takuhoTech/CelestNavi/README.md

# 星導 CelestNavi-Fusion
Ready-to-use GNSS+CLAS receiver with integrated patch antenna
