takuhoTech/CelestNavi/Hardware/Antenna_Module/Resource/GNSS_Frequency-Bands.png

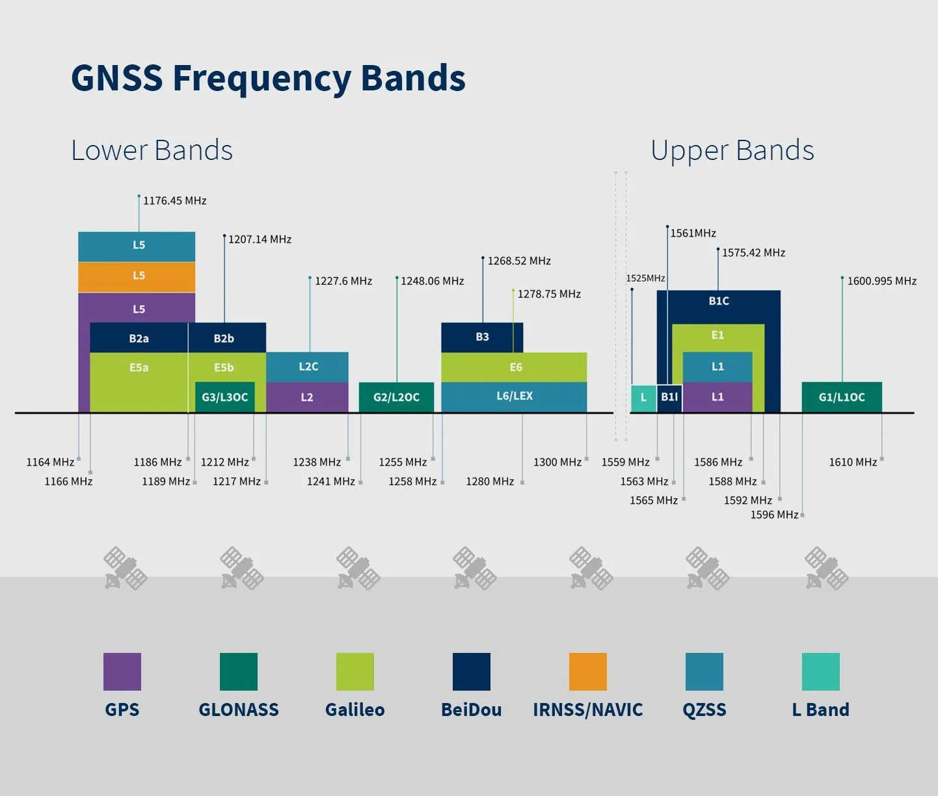
Hardware/Antenna_Module/Resource/GNSS_Frequency-Bands.png
