takuhoTech/CelestNavi/Hardware/Antenna_Module/Resource/Transmission_line.png

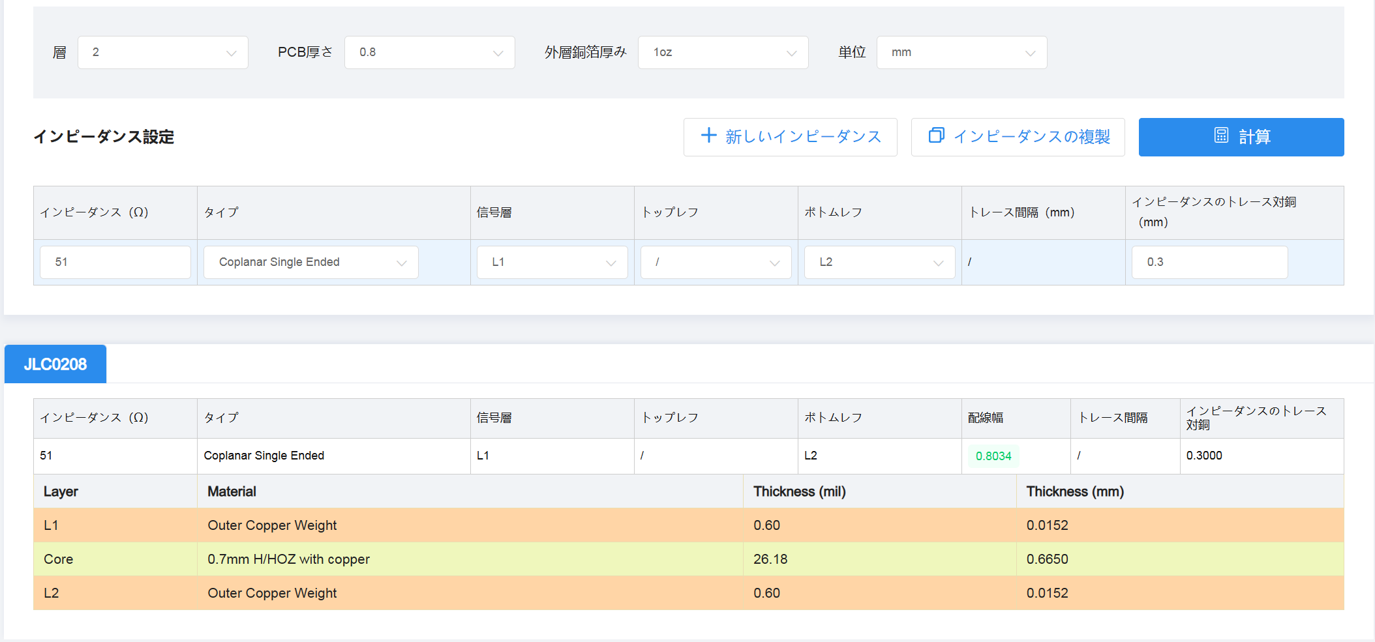
Hardware/Antenna_Module/Resource/Transmission_line.png
