takuhoTech/CelestNavi/Hardware/Antenna_Module/Resource/Via_fence_config.png

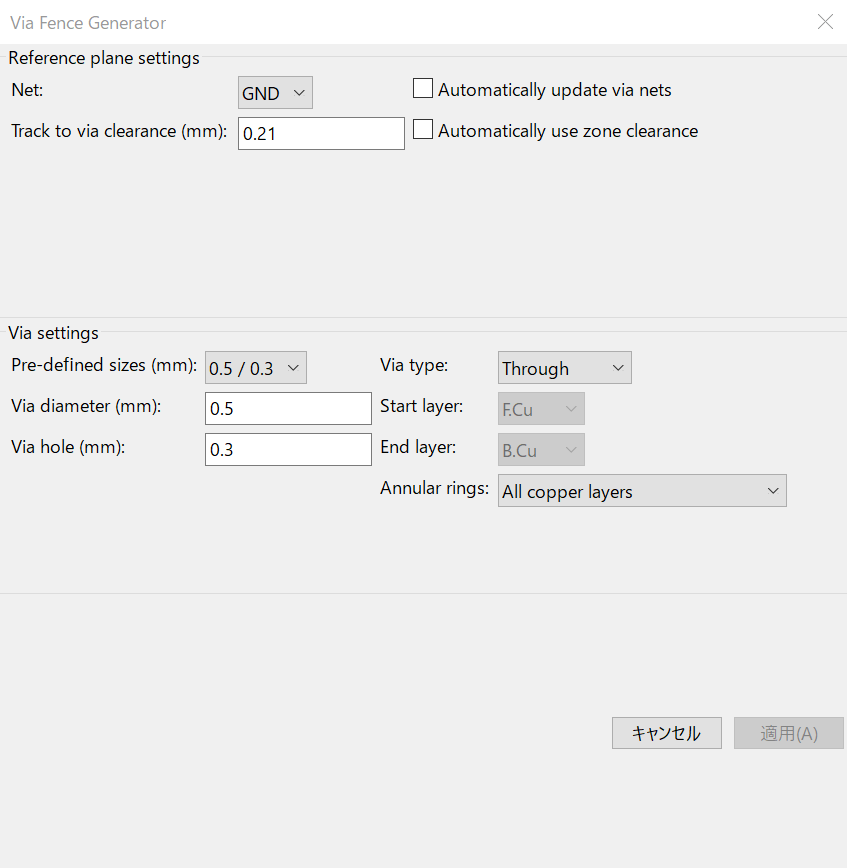
Hardware/Antenna_Module/Resource/Via_fence_config.png
