takuhoTech/CelestNavi/Hardware/Antenna_Module/Resource/Zone.png

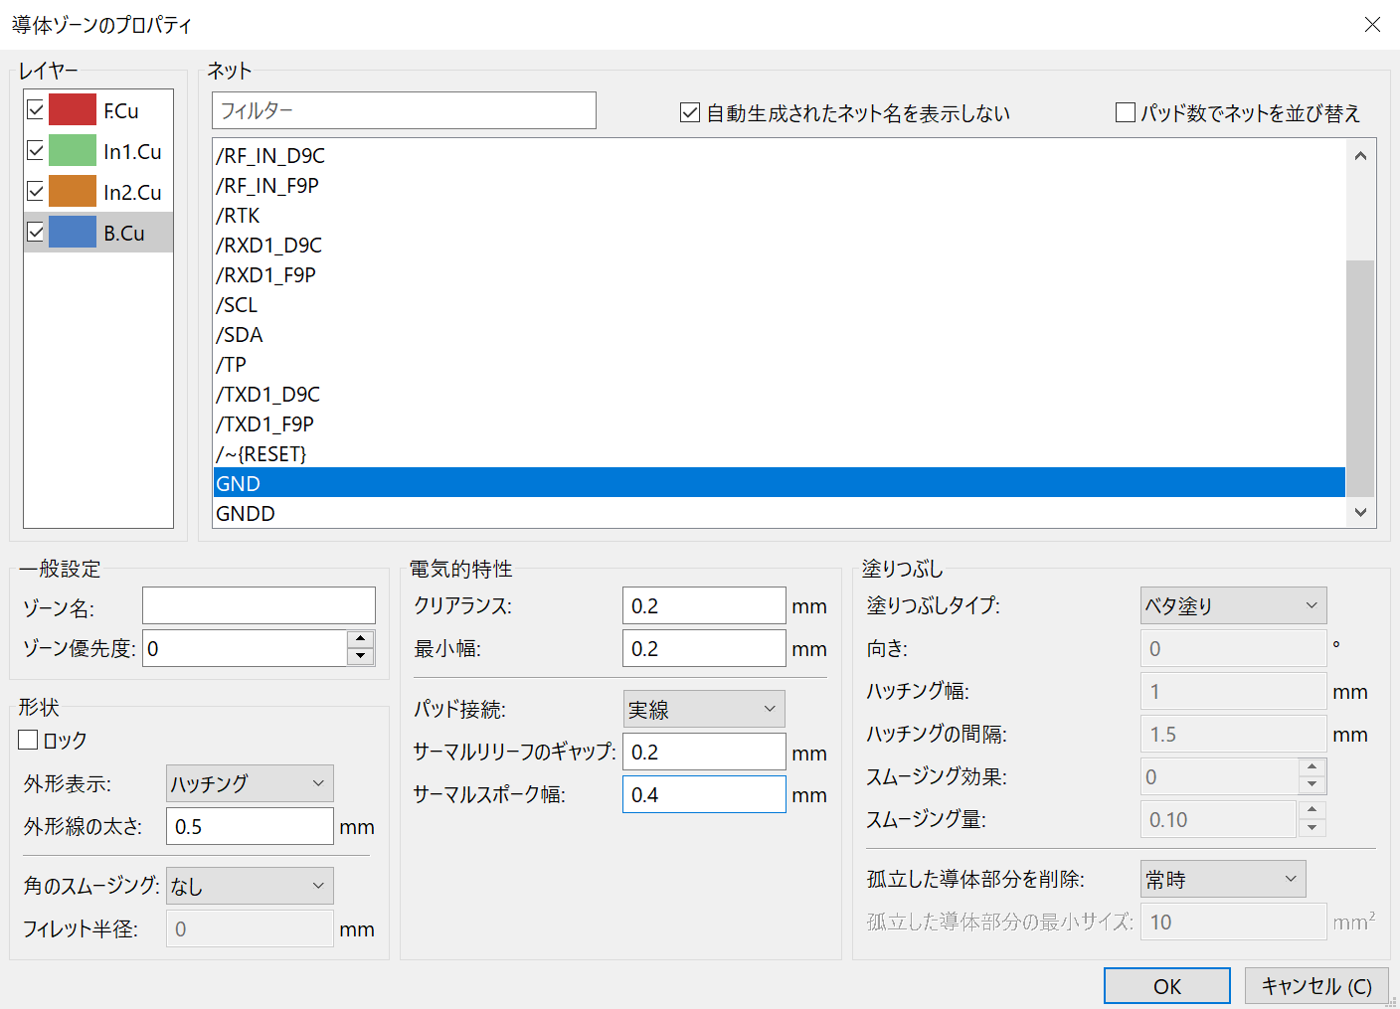
Hardware/Antenna_Module/Resource/Zone.png
