takuhoTech/CelestNavi/Hardware/Antenna_Module_with_integrated_receiver/Resource/Track0.65Core0.15.png

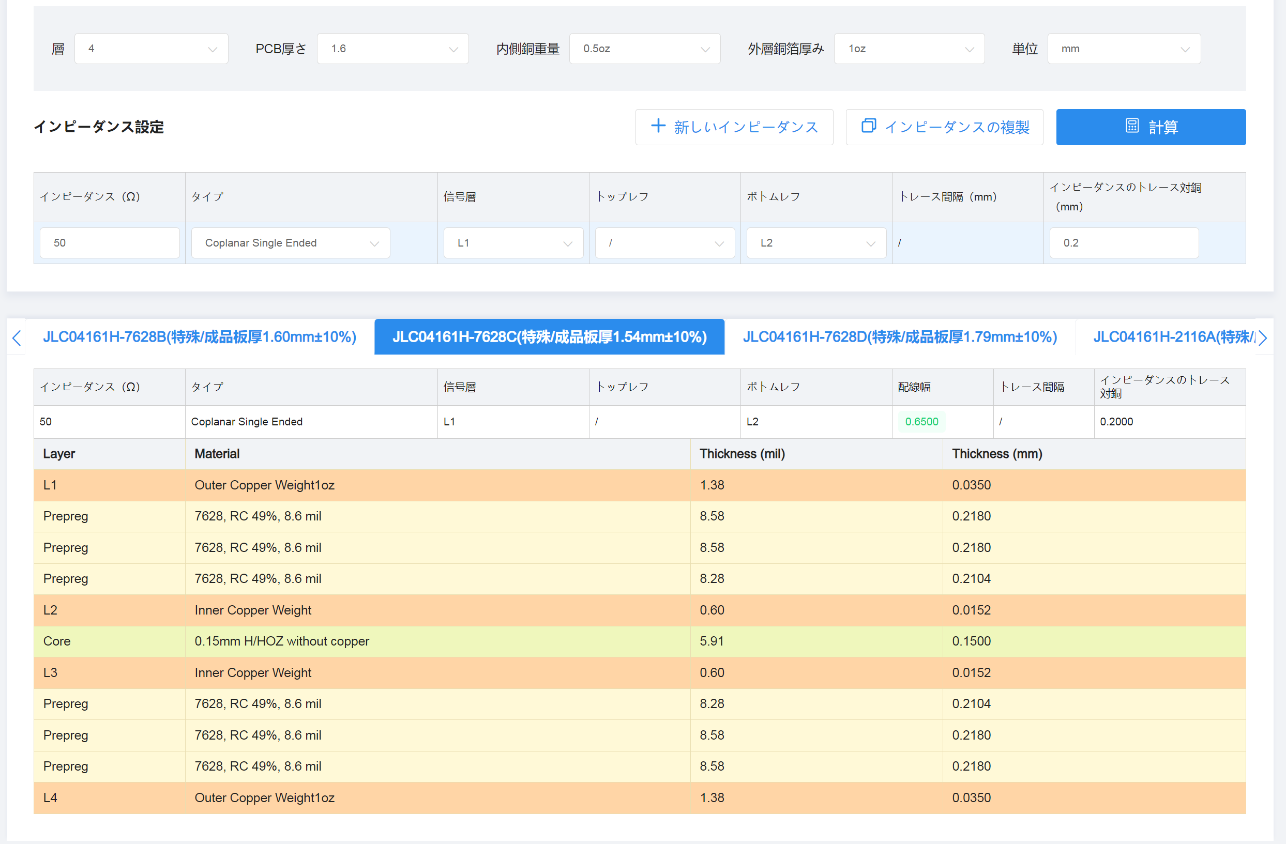
Hardware/Antenna_Module_with_integrated_receiver/Resource/Track0.65Core0.15.png
