takuhoTech/CelestNavi/Hardware/Antenna_Module_with_integrated_receiver/Resource/Track0.5499Core0.6.png

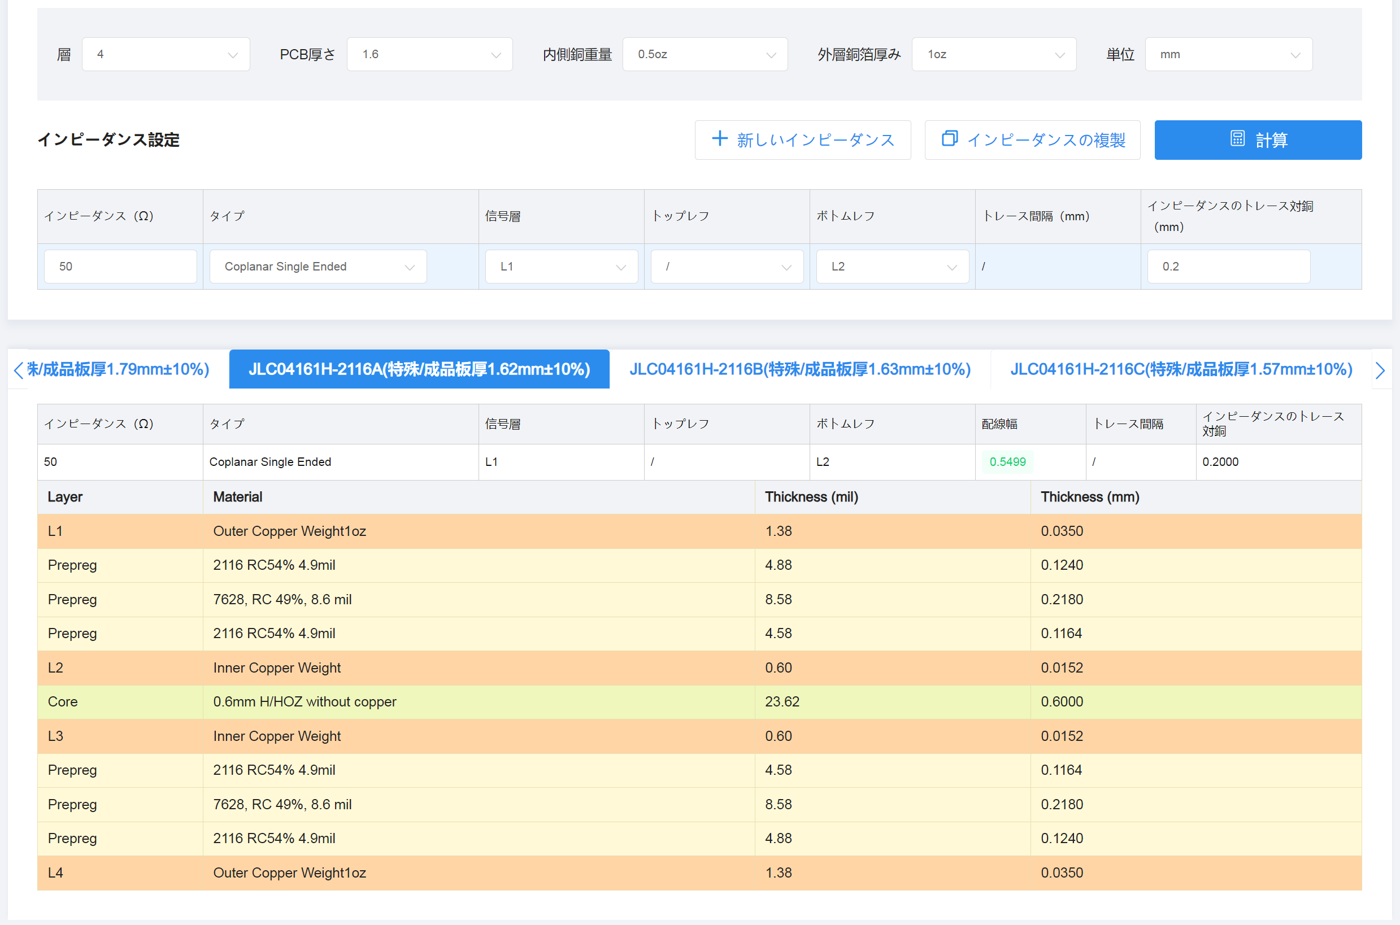
Hardware/Antenna_Module_with_integrated_receiver/Resource/Track0.5499Core0.6.png
