takuhoTech/CelestNavi/Documents/Hybrid_Coupler_Selection/Hybrid_Coupler_Selection.xlsx

型番 | 在庫 | 価格 | Freq[MHz] | Power[W] | Size[inch] | Size[mm] | ReturnLoss[dB] | InsertionLoss[dB] | IL@1200MHz | IL@1600MHz | Isolation[dB] | AmplitudeBalance[dB] | PhaseBalance[deg] | PB@1200MHz | PB@1600MHz
HC125A | Mouser 4/29/2025 | ¥859 | 1150-1630 | 30 | 0.25 x 0.20 x 0.06 | 6.35 x 5.08 x 1.524 | unknown | 0.3 | 0.15 | 0.25 | 22 | ±0.35 | 91.90 - 92.99
C0727J5003AHF | Mouser 158 | ¥206 | 700-2700 | 2 | 0.08 x 0.05 | 2.032 x 1.27 | 23 | 0.8 | 0.22 | 0.3 | 23 | ±1.90 | 90±11.0 | 1 | 2
X3C17A1-03WS | Mouser 1955 | ¥1813 | 690-2700 | 50 | 0.56 x 0.35 | 14.22 x 8.89 | 17 | 0.45 |  |  | 20 | ±0.50 | 90±5.0
C1015J5003AHF | Mouser 3980 | ¥163 | 1000-1500 | 4 | 0.08 x 0.05 | 2.032 x 1.27 | 18 | 0.6 | 0.3 | 0.55 | 20 | ±0.50 | 90±6.0
11305-3S | Mouser 2314 | ¥1048 | 1000-2000 | 60 | 0.56 x 0.35 | 14.22 x 8.89 | 17.7 | 0.45 |  |  | 20 | ±0.55 | 90±3.0
XC1400P-03S | DigiKey 472 | ¥510 | 1200-1600 | 40 | 0.25 x 0.20 | 6.35 x 5.08 | 22.1 | 0.23 | 0.12 | 0.17 | 23 | ±0.30 | 90±3.0
X3C14F1-03S | Mouser 2911 | ¥576 | 1200-1700 | 25 | 0.200 x 0.125 | 5.08 x 3.175 | 23 | 0.25 | 0.11 | 0.13 | 23 | ±0.35 | 90±4.0
X3C14P1-03S | Mouser 2772 | ¥810 | 1200-1700 | 150 | 0.25 x 0.20 | 6.35 x 5.08 | 20 | 0.2 | 0.08 | 0.09 | 23 | ±0.35 | 90±4.0 | -1 | -0.8
X3C14E2-03S | 入手不可 |  | 1200-1700 | 300 | 0.56 x 0.20 | 14.22 x 5.08 | 20 | 0.2 |  |  | 23 | ±0.35 | 90±4.0
1E1305-3 | Mouser 1366 | ¥2548 | 1200-1850 | 100 | 0.56 x 0.35 | 14.22 x 8.89 | 21 | 0.25 |  |  | 21 | ±0.50 | 90±4.0
 |  |  |  |  |  |  | 大きいほど良い | 小さいほど良い | 小さいほど良い | 小さいほど良い | 大きいほど良い
