takuhoTech/CelestNavi/Documents/Hybrid_Coupler_Selection/X3C14F1-03S/X3C14F1-03S.dxf

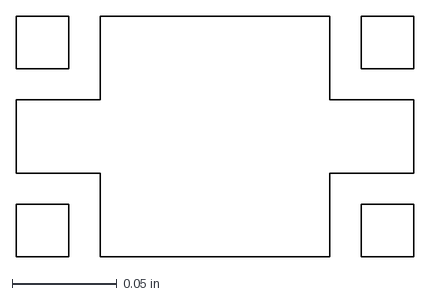
[picture p7: CAD file, 2025-04-04]
Documents/Hybrid_Coupler_Selection/X3C14F1-03S/X3C14F1-03S.dxf
0.19 x 0.115 in
