takuhoTech/CelestNavi/Documents/Hybrid_Coupler_Selection/X3C14P1-03S/X3C14P1-03S.dxf

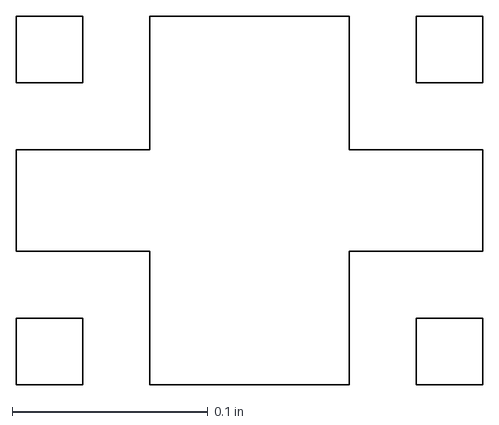
[picture p8: CAD file, 2025-04-04]
Documents/Hybrid_Coupler_Selection/X3C14P1-03S/X3C14P1-03S.dxf
0.238 x 0.188 in
