takuhoTech/CelestNavi/(list of files, cad)

Other CAD files:
Documents/Hybrid_Coupler_Selection/XC1400P-03S/XC1400P-03S.dwg
Documents/Hybrid_Coupler_Selection/X3C14P1-03S/X3C14P1-03S.dwg
