takuhoTech/CelestNavi/Hardware/Antenna_Module/Antenna_Module.kicad_pcb

## KiCad design Hardware/Antenna_Module/Antenna_Module.kicad_pcb (2025-04-15)

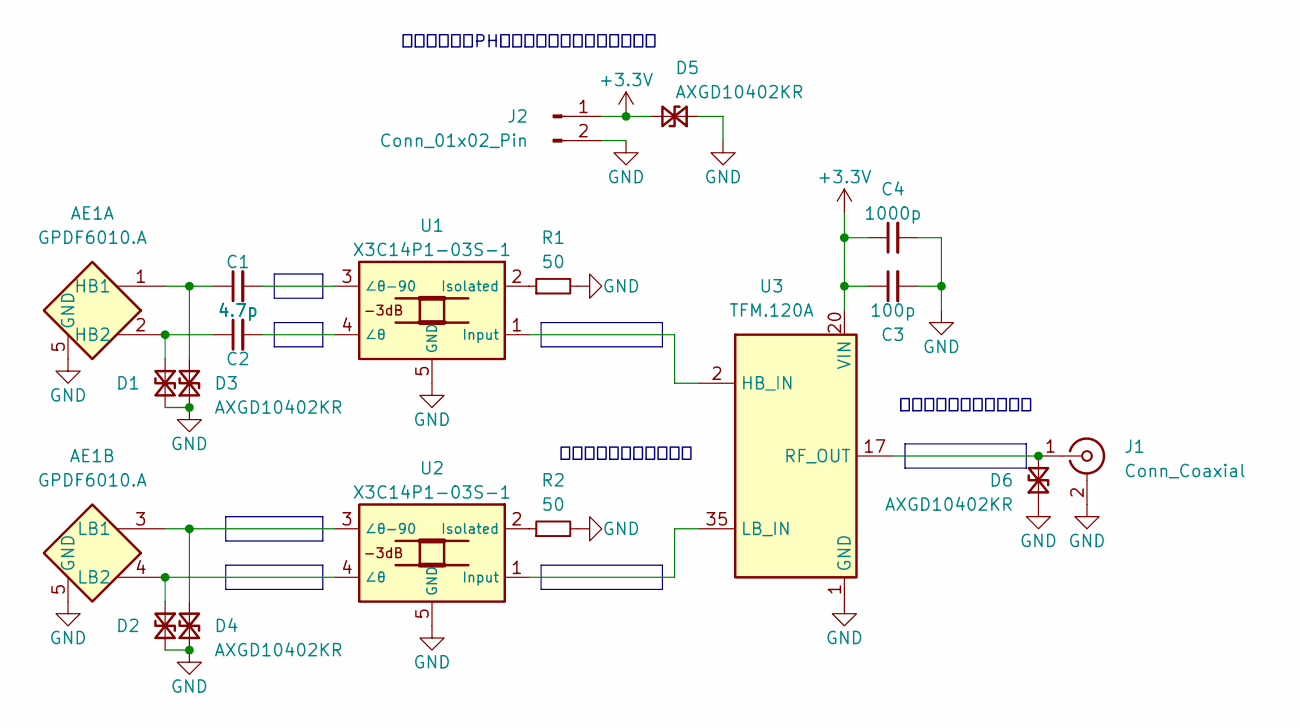
[picture p9: schematic Antenna_Module.kicad_sch]

Parts:
AE1: GPDF6010.A; Taoglas_GPDF6010.A_GNSS
C1, C2: 4.7p; C_Murata_xxx15_0402_1005Metric_1.0x0.5mm
C3: 100p; C_Murata_xxx15_0402_1005Metric_1.0x0.5mm
C4: 1000p; C_Murata_xxx15_0402_1005Metric_1.0x0.5mm
D1, D2, D3, D4, D5, D6: AXGD10402KR; D_Littelfuse_AXGD10402KR_0402_1005Metric_1.02x0.51mm
J1: Conn_Coaxial; U.FL_Hirose_U.FL-R-SMT-1_Vertical
J2: Conn_01x02_Pin; PinHeader_1x02_P2.54mm_Vertical
R1, R2: 50; R_0402_1005Metric
U1, U2: X3C14P1-03S-1; RF_HybridCoupler_TTM_X3C14P1-03S
U3: TFM.120A; Taoglas_TFM.120A_GNSS

Connections:
+3.3V: C3.1, C4.1, D5.2 (A2), J2.1, U3.20 (VIN)
GND: AE1.5 (GND), C3.2, C4.2, D1.2 (A2), D2.2 (A2), D3.1 (A1), D4.1 (A1), D5.1 (A1), D6.1 (A1), J1.2 (Ext), J2.2, R1.2, R2.2, U1.5 (GND), U2.5 (GND), U3.1 (GND), U3.3 (GND), U3.4 (GND), U3.5 (GND), U3.6 (GND), U3.7 (GND), U3.8 (GND), U3.9 (GND), U3.10 (GND), U3.11 (GND), U3.12 (GND), U3.13 (GND), U3.14 (GND), U3.15 (GND), U3.16 (GND), U3.18 (GND), U3.19 (GND), U3.21 (GND), U3.22 (GND), U3.23 (GND), U3.24 (GND), U3.25 (GND), U3.26 (GND), U3.27 (GND), U3.28 (GND), U3.29 (GND), U3.30 (GND), U3.31 (GND), U3.32 (GND), U3.33 (GND), U3.34 (GND), U3.36 (GND)
unnamed: AE1.1 (HB1), C1.1, D3.2 (A2)
unnamed: AE1.2 (HB2), C2.1, D1.1 (A1)
unnamed: AE1.3 (LB1), D4.2 (A2), U2.3 (∠θ-90)
unnamed: AE1.4 (LB2), D2.1 (A1), U2.4 (∠θ)
unnamed: D6.2 (A2), J1.1 (In), U3.17 (RF_OUT)
unnamed: U1.1 (Input), U3.2 (HB_IN)
unnamed: R1.1, U1.2 (Isolated)
unnamed: C2.2, U1.4 (∠θ)
unnamed: C1.2, U1.3 (∠θ-90)
unnamed: U2.1 (Input), U3.35 (LB_IN)
unnamed: R2.1, U2.2 (Isolated)

Notes on the sheet:
ピンの極性はPHコネクタに刺さるリポと同じ
出力マッチング回路省略
入力マッチング回路省略

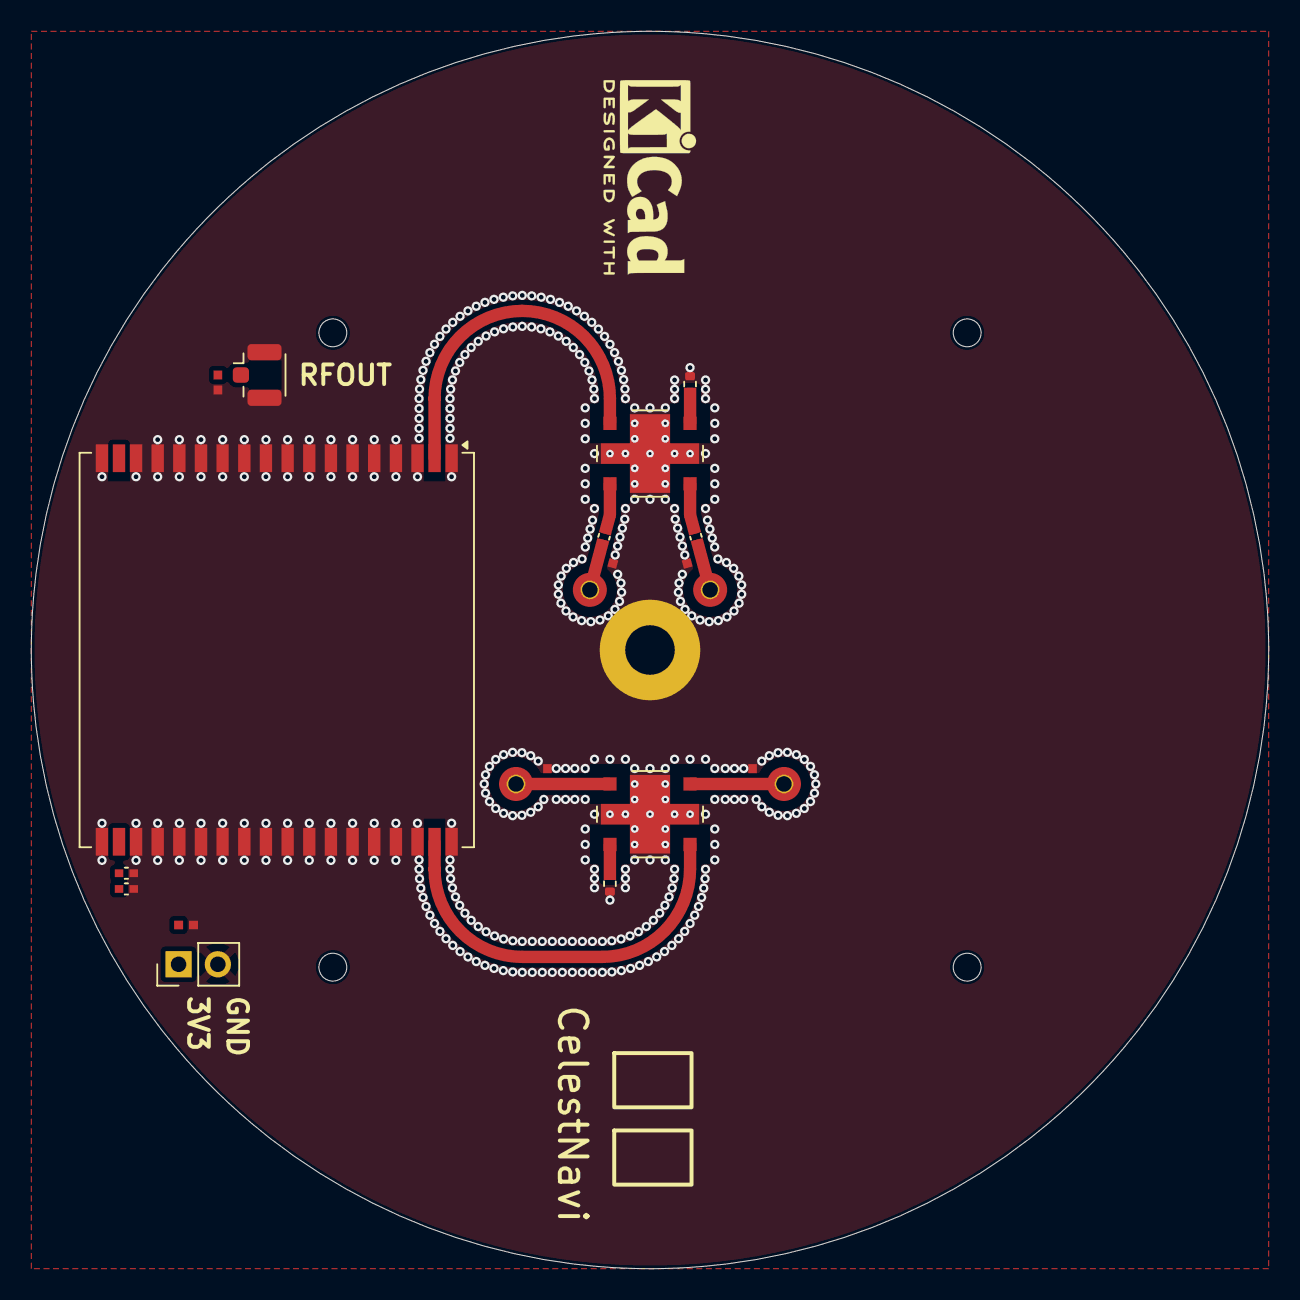
[picture p10: board Antenna_Module.kicad_pcb from above]

Board: 2 copper layers, 80.0 x 80.0 mm, 18 parts (1 on the bottom side), 13 nets.
