takuhoTech/CelestNavi/(commit log)

2024-08-18 KiCadプロジェクトを追加
    [AntennaModule.kicad_pcb, AntennaModule.kicad_sch, ReceiverModule.kicad_pcb, ReceiverModule.kicad_sch]
2024-10-24 フロントエンド仮完成
    [AntennaModule.kicad_pcb, AntennaModule.kicad_sch, EAHP.50.01.0100D_Web.STEP, Front-End.kicad_sch]
2024-11-09 TE0149AをTE0133Bに変更
    [AntennaModule.kicad_pcb, AntennaModule.kicad_sch, Front-End.kicad_sch]
2024-12-17 回路図完成
    [AntennaModule.kicad_pcb, AntennaModule.kicad_sch, Front-End.kicad_sch]
2024-12-19 アンテナの給電点が逆になっていたのを修正
    [AntennaModule.kicad_pcb, AntennaModule.kicad_sch, Front-End.kicad_sch, TAOGLAS_GPDF6010.A.SchLib, TAOGLAS_GPDF6010.A.dxf]
2024-12-19 アンテナのFP修正に伴う回路図の修正
    [AntennaModule.kicad_pcb, Front-End.kicad_sch]
2024-12-19 グリッドとドリルの原点を設定
    [AntennaModule.kicad_pcb]
2025-01-02 部品配置決定
    [AntennaModule.kicad_pcb, Front-End.kicad_sch]
2025-01-09 スタックアップを決定
    [AntennaModule.kicad_pcb, AntennaModule.kicad_sch, Front-End.kicad_sch]
2025-01-13 円弧配線に対応
    [AntennaModule.kicad_pcb]
2025-01-25 RFフロントエンド配線完了
    [AntennaModule.kicad_pcb]
2025-01-26 add GND plane
    [AntennaModule.kicad_pcb]
2025-03-26 レシーバ無し版の回路図完成
    [AntennaModule.kicad_pcb, AntennaModule.kicad_sch, Antenna_Module.kicad_pcb, Antenna_Module.kicad_sch, Antenna_Module_with_integrated_receiver.kicad_pcb, Antenna_Module_with_integrated_receiver.kicad_sch, Front-End.kicad_sch, ReceiverModule.kicad_pcb]
2025-03-27 データシート整理
    [Antenna_Module.kicad_pcb, Antenna_Module.kicad_sch, EAHP.50.01.0100D_Web.STEP, TAOGLAS_GPDF6010.A.SchLib, TAOGLAS_GPDF6010.A.dxf]
2025-04-04 基板設定済み
    [Antenna_Module.kicad_pcb, Antenna_Module.kicad_sch, Hybrid_Coupler_Selection.xlsx, X3C14F1-03S.dxf, X3C14P1-03S.dwg, X3C14P1-03S.dxf, XC1400P-03S.dwg]
2025-04-13 ビア配置
    [Antenna_Module.kicad_pcb]
